Duoslow/ugreen-switch/(commit log)

2026-10-17 UGREEN DP switch PC control: NodeMCU firmware, tray app, CLI
2026-10-17 Mark solder points on board photo
